XavierSulli/Mangeoire_Connectee/ReadMe.txt

Ajoute ton nom pour voir si ca fonctionne
