XavierSulli/Mangeoire_Connectee/(list of files, drawings)

Other design files:
Mangeoire_Connectee-master/mangeoire/MANGEOIRE.DSN
Mangeoire_Connectee-master/mangeoire/mangeoire.opj
