XavierSulli/Mangeoire_Connectee/Mangeoire_Connectee-master/New Code/New Code/bsp/inc/util.h

/*
 * util.h
 *
 *  Created on: 6 avr. 2019
 *      Author: Laurent
 */

#ifndef BLUENRG_MS_UTIL_H_
#define BLUENRG_MS_UTIL_H_

#include "stm32l4xx.h"
#include "bluenrg_def.h"


uint8_t 	getBlueNRGVersion	(uint8_t *hwVersion, uint16_t *fwVersion);



#endif /* BLUENRG_MS_UTIL_H_ */
