XavierSulli/Mangeoire_Connectee/(commit log)

2020-09-28 first commit
    ajout des fichier que Latorre nous as fournis
    [MANGEOIRE.DSN, mangeoire.opj]
2020-10-02 Added Quentin's docs
    Documents and codes from precedent projects
    [MANGEOIRE.DSN, mangeoire.opj]
